lowhnn/tank_controllers/MasterArduino/UABC_Box_Diagram.png

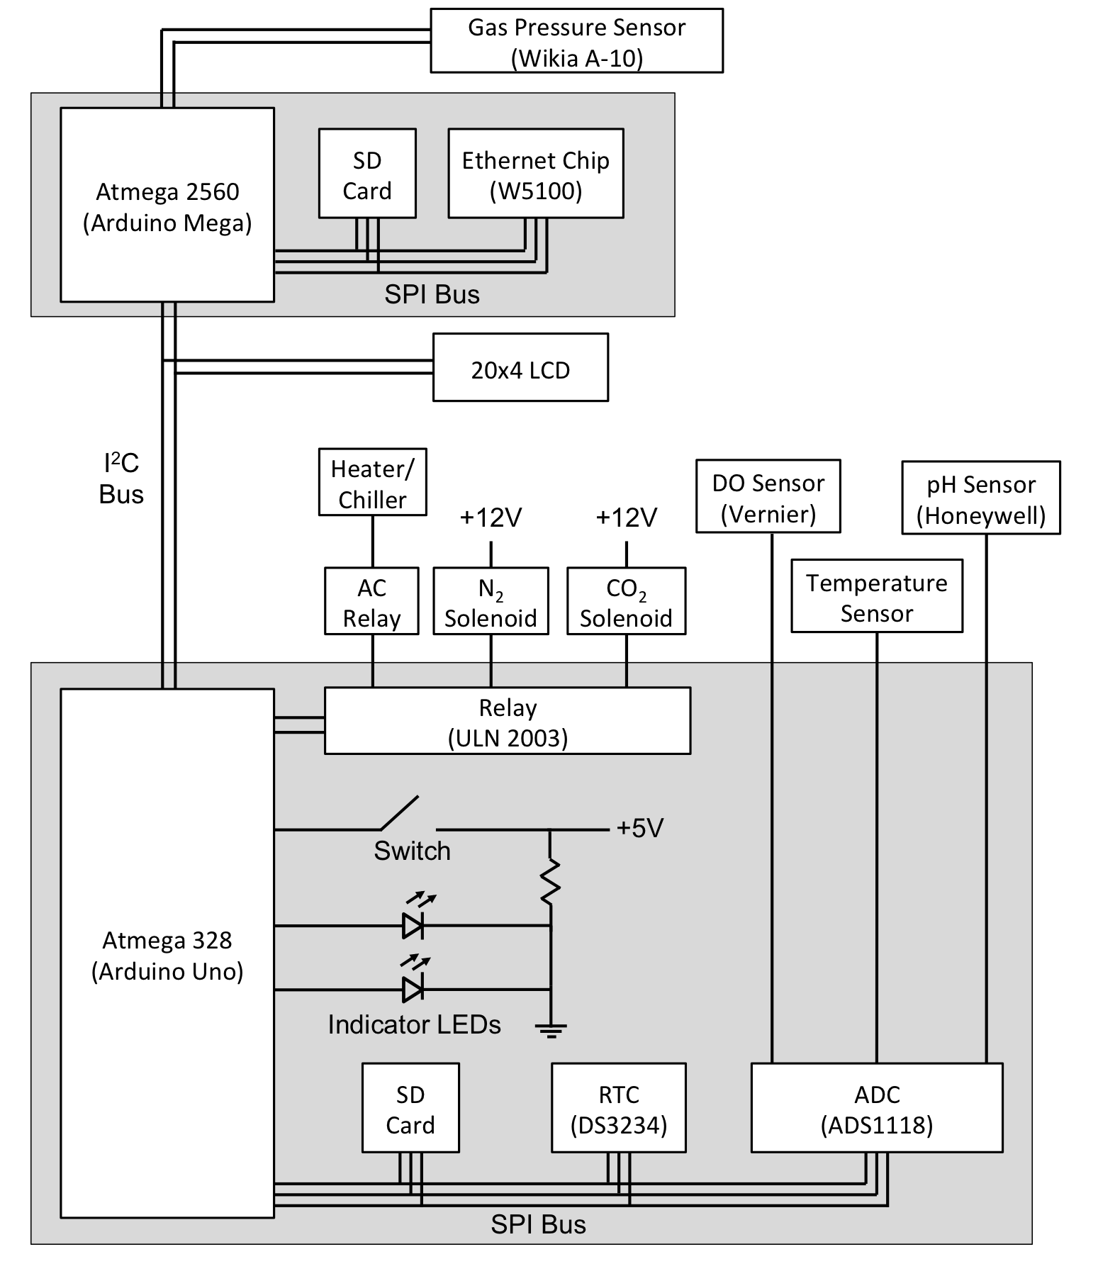
MasterArduino/UABC_Box_Diagram.png
