lowhnn/tank_controllers/MasterArduino/UABC_Layout.png

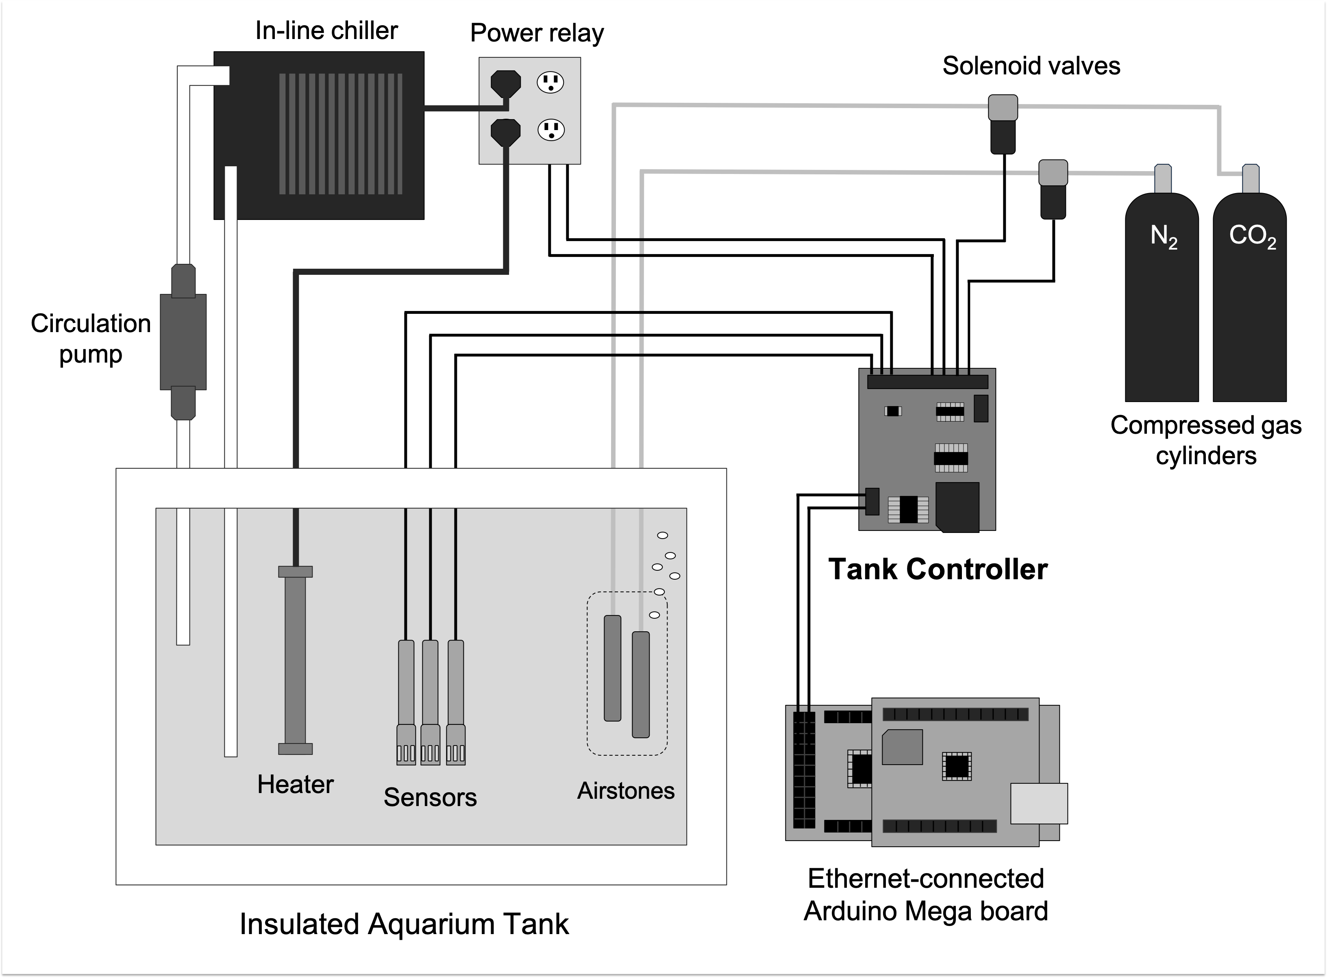
MasterArduino/UABC_Layout.png
