lowhnn/tank_controllers/TankController/TankControllerSchematics/TankControllerPartList.md

# Parts list for Tank Controller Board

| Part Type | Manufacturer | Part name | Description | Mount | Newark Part No. | Digikey Part No. | Datasheet | 
|---|---|---|---|---|---|---|---|
| ADC | TI | ADS1118 | 16-bit SPI ADC | SMD | 57T9643 | | | 
| Battery | Panasonic | CR1220 | CR1220 coin battery, 3V, 12.5mm | | | P033-ND | | 
| Battery holder | | 3000TR | 12.5mm battery holder for CR1220 coin battery | SMD | | 3000KCT-ND | | 
| LED | Lite-On | LTST-C191KGKT | 0603 Surface mount green LED | SMD | | 160-1446-1-ND | http://optoelectronics.liteon.com/upload/download/DS22-2000-228/S_110_LTST-C191KGKT.pdf | 
| LED | Lite-On | LTST-C191KRKT | 0603 Surface mount red LED | SMD | | 160-1447-1-ND | | 
| Logic shifter | TI | CD74HC4050M96 | 6-channel hex buffer (for logic shifting between Arduino 5V and SD card 3.3V) | SMD | | 296-14529-1-ND | http://www.ti.com/lit/ds/symlink/cd74hc4049.pdf | 
| Relay | TI | ULN2003AN | High voltage high current transistor array | DIP | 60K7049 | 296-1979-5-ND | http://www.ti.com/lit/ds/symlink/uln2003a.pdf | 
| Resistor | | | 0603 10K resistor | SMD | | | | 
| Resistor | Panasonic | ERJ-3GEYJ102V | 0603 1K resistor | SMD | | P1.0KGCT-ND | | 
| RTC | Maxim | DS3234 | SPI Real Time Clock | SMD | | DS3234S#T&RCT-ND | http://datasheets.maximintegrated.com/en/ds/DS3234.pdf | 
| Screw terminal | TE connectivity | 282834-2 | 2-position slim screw terminal block | DIP | 12H8386 | | http://www.farnell.com/datasheets/1650926.pdf?_ga=1.14641589.322097644.1469639038 | 
| SD card socket | Molex | 5027740891 | microSD card holder, reverse mount (pins exposed) | SMD | | WM24066CT-ND | http://www.molex.com/pdm_docs/sd/5027740891_sd.pdf | 
| Socket | Multicomp | SPC15498 | 16-pin DIP socket | DIP | 82K7788 | | | 
| Switch | C&K | GT12MSABE | Surface mount toggle switch | SMD | | CKN9049CT-ND | | 
| Voltage regulator | TI | LP2985AIM5-3.0 | 3V Linear voltage regulator | SMD | | LP2985AIM5-3.0/NOPBCT-ND | http://www.ti.com/lit/ds/symlink/lp2985-n.pdf | 
| Capacitor | | | 0603 22pF ceramic capacitor | SMD | | | | 
| Capacitor | Kemet | C0603C104K4RACTU | 0603 0.1 uF ceramic capacitor | SMD | | 399-1096-1-ND | | 
| Capacitor | | | 0603 10uF ceramic capacitor | SMD | | | | 
| Capacitor | | | 0603 100nF ceramic capacitor | | | | | 
| Connector | TE connectivity |  4-103185-0 | 40 position header connector, 0.1" pitch | DIP | | A26513-40-ND | |
