lowhnn/tank_controllers/TankController/TankControllerSchematics/TankControllerShield.brd

## EAGLE design TankController/TankControllerSchematics/TankControllerShield.brd (2019-10-21)

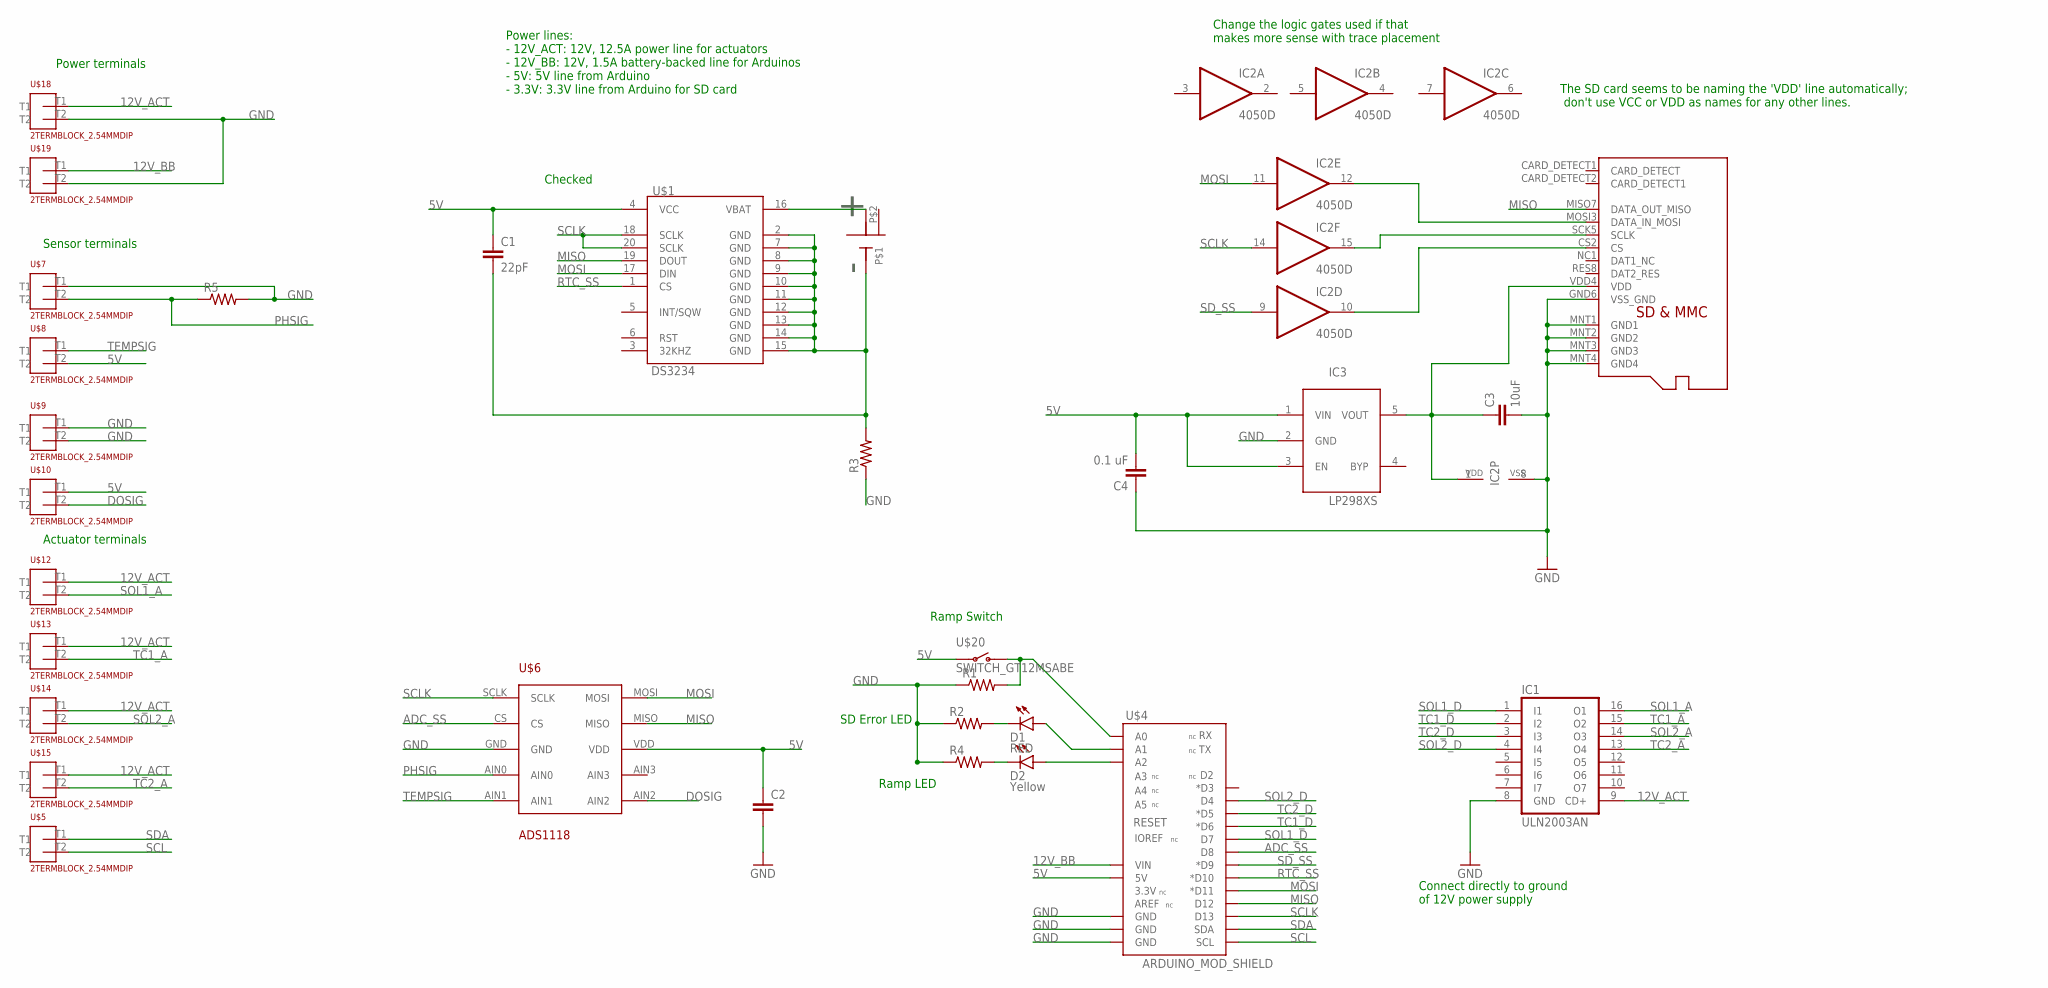
[picture p3: schematic TankControllerShield.sch]

Parts:
C1: 22pF; 0603-CAP
C2: CAP0603-CAP; 0603-CAP
C3: 10uF; 0603-CAP
C4: 0.1 uF; 0603-CAP
D1: RED; LED-0603
D2: Yellow; LED-0603
IC1: ULN2003AN; DIL16
IC2: 4050D; SO16
IC3: LP298XS; SOT23-5L
R1, R2, R3, R4, R5: RESISTOR0603-RES; 0603-RES
U$1: DS3234
U$2: CR1220_BATTERY_HOLDERSMD; CR1220_BATTERY_HOLDER_SMD
U$3: MICROSD_MOLEX_REVERSE; MICROSD_SOCKET_MOLEX_REVERSEMOUNT
U$4: ARDUINO_MOD_SHIELD; UNO_MOD_SHIELD
U$5, U$7, U$8, U$9, U$10, U$12, U$13, U$14, U$15, U$18, U$19: 2TERMBLOCK_2.54MMDIP; 2TERMBLOCK_2.54MM
U$6: ADS1118
U$20: SWITCH_GT12MSABE; TOGGLESWITCH

Connections:
3V: C3.1, IC2.1 (VDD), IC3.5 (VOUT), U$3.VDD4 (VDD)
5V: C1.1, C2.1, C4.2, IC3.1 (VIN), IC3.3 (EN), U$1.4 (VCC), U$4.5V, U$6.VDD, U$8.T2, U$10.T1, U$20.1
12V_ACT: IC1.9 (CD+), U$12.T1, U$13.T1, U$14.T1, U$15.T1, U$18.T1
12V_BB: U$4.VIN, U$19.T1
ADC_SS: U$4.D8, U$6.CS
DOSIG: U$6.AIN2, U$10.T2
GND: C2.2, C3.2, C4.1, IC1.8 (GND), IC2.8 (VSS), IC3.2 (GND), R1.1, R2.1, R3.1, R4.1, R5.2, U$3.GND6 (VSS_GND), U$3.MNT1 (GND1), U$3.MNT2 (GND2), U$3.MNT3 (GND3), U$3.MNT4 (GND4), U$4.GND@0 (GND), U$4.GND@1 (GND), U$4.GND@2 (GND), U$6.GND, U$7.T1, U$9.T1, U$9.T2, U$18.T2, U$19.T2
MISO: U$1.19 (DOUT), U$3.MISO7 (DATA_OUT_MISO), U$4.D12, U$6.MISO
MOSI: IC2.11 (I), U$1.17 (DIN), U$4.D11 (*D11), U$6.MOSI
unnamed: U$1.16 (VBAT), U$2.P$1 (VBAT)
unnamed: IC2.12 (O), U$3.MOSI3 (DATA_IN_MOSI)
unnamed: IC2.15 (O), U$3.SCK5 (SCLK)
unnamed: IC2.10 (O), U$3.CS2 (CS)
unnamed: D1.A, U$4.A1
unnamed: D2.A, U$4.A2
unnamed: D1.C, R2.2
unnamed: C1.2, R3.2, U$1.2 (GND), U$1.7 (GND), U$1.8 (GND), U$1.9 (GND), U$1.10 (GND), U$1.11 (GND), U$1.12 (GND), U$1.13 (GND), U$1.14 (GND), U$1.15 (GND), U$2.GND
unnamed: D2.C, R4.2
unnamed: R1.2, U$4.A0, U$20.3
PHSIG: R5.1, U$6.AIN0, U$7.T2
RTC_SS: U$1.1 (CS), U$4.D10 (*D10)
SCL: U$4.SCL, U$5.T2
SCLK: IC2.14 (I), U$1.18 (SCLK), U$1.20 (SCLK), U$4.D13, U$6.SCLK
SDA: U$4.SDA, U$5.T1
SD_SS: IC2.9 (I), U$4.D9 (*D9)
SOL1_A: IC1.16 (O1), U$12.T2
SOL1_D: IC1.1 (I1), U$4.D7
SOL2_A: IC1.14 (O3), U$14.T2
SOL2_D: IC1.4 (I4), U$4.D4
TC1_A: IC1.15 (O2), U$13.T2
TC1_D: IC1.2 (I2), U$4.D6 (*D6)
TC2_A: IC1.13 (O4), U$15.T2
TC2_D: IC1.3 (I3), U$4.D5 (*D5)
TEMPSIG: U$6.AIN1, U$8.T1

Notes on the sheet:
Connect directly to ground of 12V power supply
Change the logic gates used if that makes more sense with trace placement
The SD card seems to be naming the 'VDD' line automatically; don't use VCC or VDD as names for any other lines.
Power terminals
Sensor terminals
Actuator terminals
Power lines: - 12V_ACT: 12V, 12.5A power line for actuators - 12V_BB: 12V, 1.5A battery-backed line for Arduinos - 5V: 5V line from Arduino - 3.3V: 3.3V line from Arduino for SD card
Checked
Ramp Switch
SD Error LED
Ramp LED

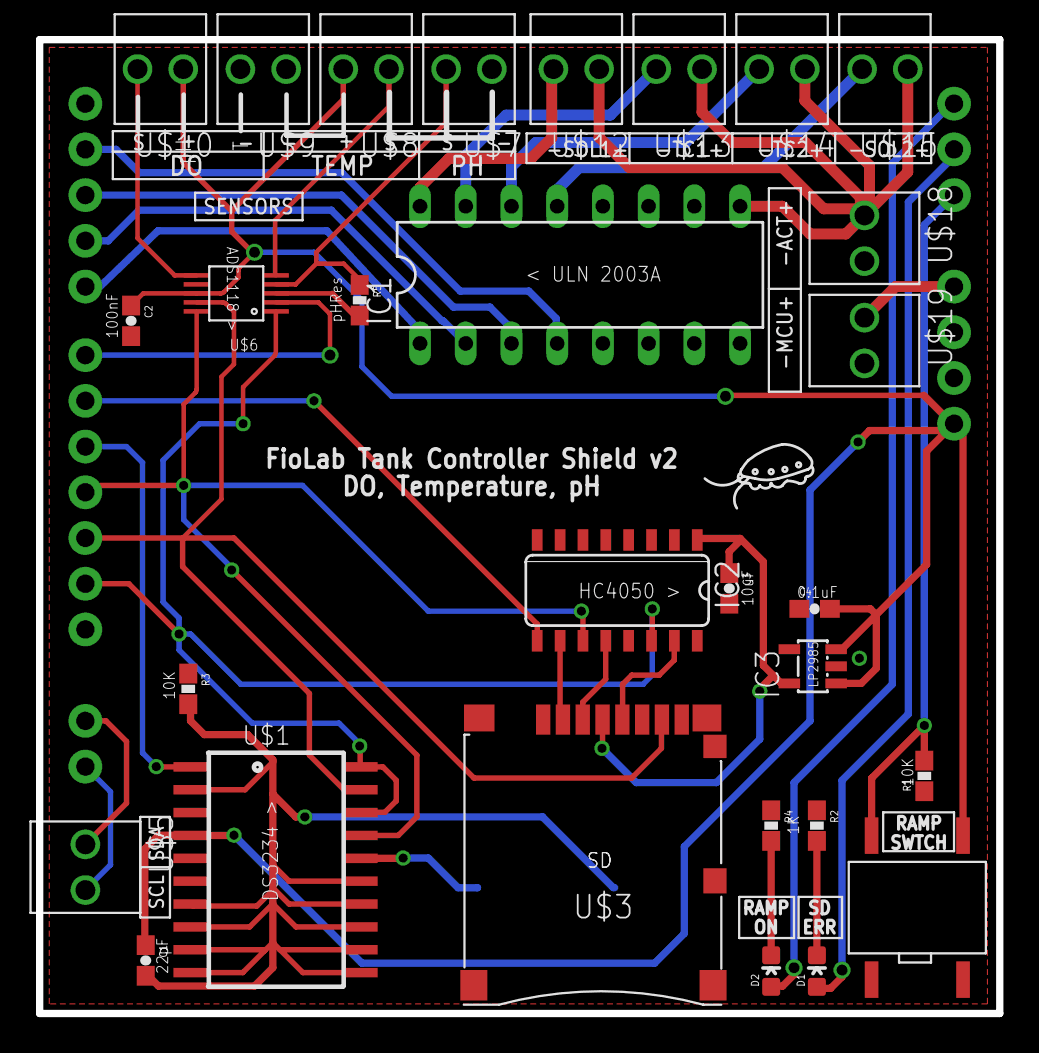
[picture p4: board TankControllerShield.brd from above]

Board: 2 copper layers, 53.3 x 54.1 mm, 31 parts (1 on the bottom side), 34 nets.
